davidclifford/8-bit-cpu/README.md

# David's 8-bit-cpu

Inspired by the Ben Eater series of videos on youtube https://www.youtube.com/playlist?list=PLowKtXNTBypGqImE405J2565dvjafglHU

Also see James Bates videos https://www.youtube.com/watch?v=gqYFT6iecHw&list=PL_i7PfWMNYobSPpg1_voiDe6qBcjvuVui

## Improvements and thoughts

Ben Eaters CPU is 8-bit but it uses only 4 bits for the address giving it only 16 locations for instructions and/or data.
The most obvious improvement is to use an 8 bit address giving 256 locations for instructions or data.
However this also means that programming the CPU with DIP switches can be tedious and error prone.
This can be overcome by using a ROM to store the program instead.

Output to a 4 digit display can be augmented by adding a UART for input and output to a PC using a terminal emulator like PuTTY.

The control unit can be extended by adding two more ROMS to make the CPU more powerful with 32 control lines.

I used 8 bits for the instruction giving a maximum possible 256 instructions, 3 bits for the t-states, giving 8 t-states,
a t-state reset so that shorter instructions could end early and 2 bits for flags. This gives 8+3+2 = 13 address bits
needing 8k ROMS for the control lines. This is enough for addressing an 8k byte ROM such as the 28C64.

Carry is one flag and the other flags are multiplexed from the carry register and UART by using the last 3 bits of the instruction.
They are Negative, Zero, Overflow, Input ready and Output ready from the UART.  

With an 8-bit instruction word any operand need would normally be in the next byte in memory but to give me more available
space I put the instruction in the ROM at address plus 256 byes and the operands in the first 256 bytes.

This uses a simple circuit modification where when the instruction is fetched from the ROM it also sets the 9th bit of the ROM address
and gets it from there, where as the operands do not set the 9th address line and so are in the first 256 bytes.
This will almost double the amount of memory I can use for my programs but still keep all the addresses 8 bits long.
 
## For my CPU I used

- A 32k RAM chip (but only using 256 bytes!)
- A 8k ROM for instructions/data (but only using ~500 bytes)
- 4 ROMS for the control signals (28C64) giving 32 control lines
- 4 general purpose data registers (A,B,C,D)
- An 8-bit stack pointer (SP)
- 2 74161 counters for the PC giving 256 byte address space
- 2 74382 chips for the ALU giving AND, OR and XOR as well as ADD and SUB
- Having write-only registers for the inputs to the ALU (X,Y)
- A mux from the bus to the X & Y registers that reverse the bits for right shifts
- A mux as a zero input to the ALU Y input so that the ALU can add 1, 0 or -1 to X depending on the ALU function and carry in
- Connecting the Instruction Register input straight from the Memory, bypassing the data bus, which makes the fetch cycle only need 1 t-state instead of 2
- Using a um245r UART as an input/output device and 2 extra flags for input ready and output ready.
- Using a 28C64 ROM for the multiplexed 4 digit display giving signed & unsigned decimal, octal, hex and a simple ascii display
- 3mm LEDs with built in resistors in red and green, making it easy to fit them to the breadboards. 

## Software & hardware tools

- Using a MiniPro ROM burner to program the ROMs from a PC as this is more powerful than using an Arduino programmer
- Python to generate the control and digital display ROMS
- Python assembler and emulator

## Why use X and Y write-only registers in the ALU?

I reasoned that if I had 2 dedicated registers for the inputs to the ALU it would leave
the other registers free to do whatever they needed. It also allowed other registers
like the PC and Stack Pointer to use the ALU without affecting the general purpose registers.
They do need 2 extra control lines and complicate the ALU some more but makes it far more flexible.

## Right shifts

The technique I use is very unorthodox. I knew that left shifts were relatively easy, just add a number to itself.
This also means that I could use carry in to shift bits in and carry out to shift bits out and zero detect
came for free. So I reasoned that right shifts are the same as left shifts but in the opposite direction, so why not
just reverse the bits of the X & Y registers before adding them together and then reversing the bits on
the output. This worked but added a few more chips to the ALU. I've never heard of anyone doing this before.

# Other instructions

- HALT: in Ben Eaters CPU the HALT instruction stopped the clock with a control line but you can remove
that by getting the HALT instruction to decrement the PC via the ALU, so that it will produce
an infinite loop in the micro-code and free up a control line on the control ROMS.

## Build Tips

Use the best quality breadboards you can afford. I started with Elegoo breadboards and they were terrible.
So I ended up buying BPS BB830 breadboards, the ones Ben Eater recommended, and had very little problems from then on.
I used some of the BB830 power rails down the side of the CPU to distribute power rather than wires from one 
board to the next. I used the Elegoo power rails for my 8-bit bus as their high(ish) resistance (about 100 ohms)
were still able to carry TTL signals without too much trouble.

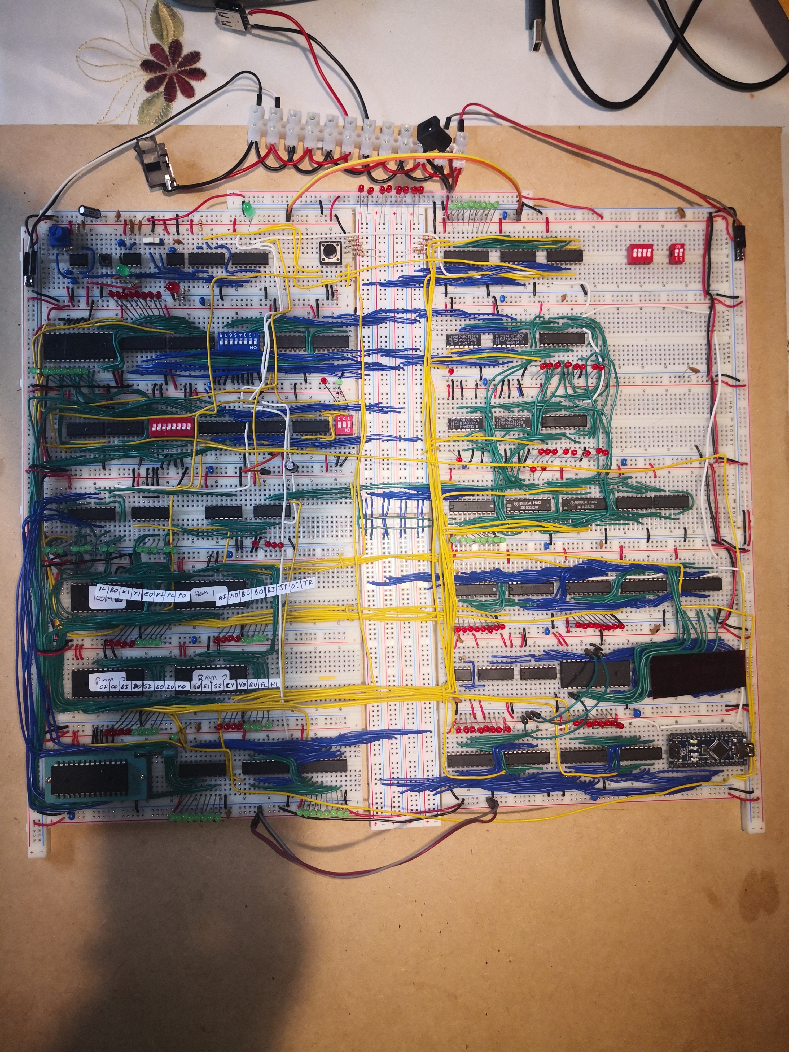
[picture p1: 8-bit-cpu.jpg]
8 bit cpu
