davidclifford/8-bit-cpu/(list of files, drawings)

Other design files:
Logisim/dice3.circ
Logisim/dice.circ
