davidclifford/8-bit-cpu/Docs/instructions.xls

add | a | r2/#
adc | a | r2/#
sub | a | r2/#
sbb | a | r2/#
and | a | r2/#
or | a | r2/#
xor | a | r2/#
not | r1
neg | r1
lsl | r1
lsr | r1
inc | r1
dec | r1
mov | r1 | #
mov | r1 | r2
ld | r1 | (#)
ld | r1 | (r2)
st | r1 | (#)
st | r1 | (r2)
jmp | addr
jpc | addr
jpz | addr
jpv | addr
jpn | addr
call | addr
ret
push | r1/#
pop | r1
nop
hlt
out | r1
out | #
r1 | a,b,c,d
# | literal number
(#) | contents of address
(r2) | contents of address in r2
0 | 0
1 | B-A
2 | A-B
3 | A+B
4 | A^B
5 | A|B
6 | A&B
7 | -1
