davidclifford/8-bit-cpu/(commit log)

2019-02-20 Modified alpha chars a bit
    [instructions.xls]
2019-04-23 Fix bug in instruction-set printContents
    [instruction-set.ino]
2019-05-04 3 roms wired up
2019-05-08 Fix some of the instructions
    [instruction-set.py]
2019-05-08 Print out control bits as mnemonics
2019-05-09 Fix jump and nop opcodes
    [instruction-set.py]
2019-05-09 Start on assembler
2019-05-10 Assembler mk1
2019-05-12 fix ror lsr instructions
    [instruction-set.py]
2019-05-13 Make assembler module
2019-05-27 Jump on condition update & fix CMP instruction
    [instruction-set.py]
2019-06-03 Input works, scrolling text failure!
    [display.ino]
2019-06-04 Fix CALL instruction. scroll_test now works
    [instruction-set.py]
2019-06-04 improve scroll text and assembler
2019-06-12 updated instruction set and assembler to use new architecture
2019-06-16 fix call & ret instructions
    [instruction-set.py]
2019-07-08 Update assembler to jump on IO, remove calr & jpr
2019-07-13 test prog for uart output
2019-09-16 test programs after fixing cpu
    [dice.circ]
2019-10-07 div test
    [dice3.circ]
2019-10-10 Fix rol and ror instructions
    [instruction-set.py]
